Rampopula/mazda_dp_parktronic/mazda_dp_ptronic.pdf

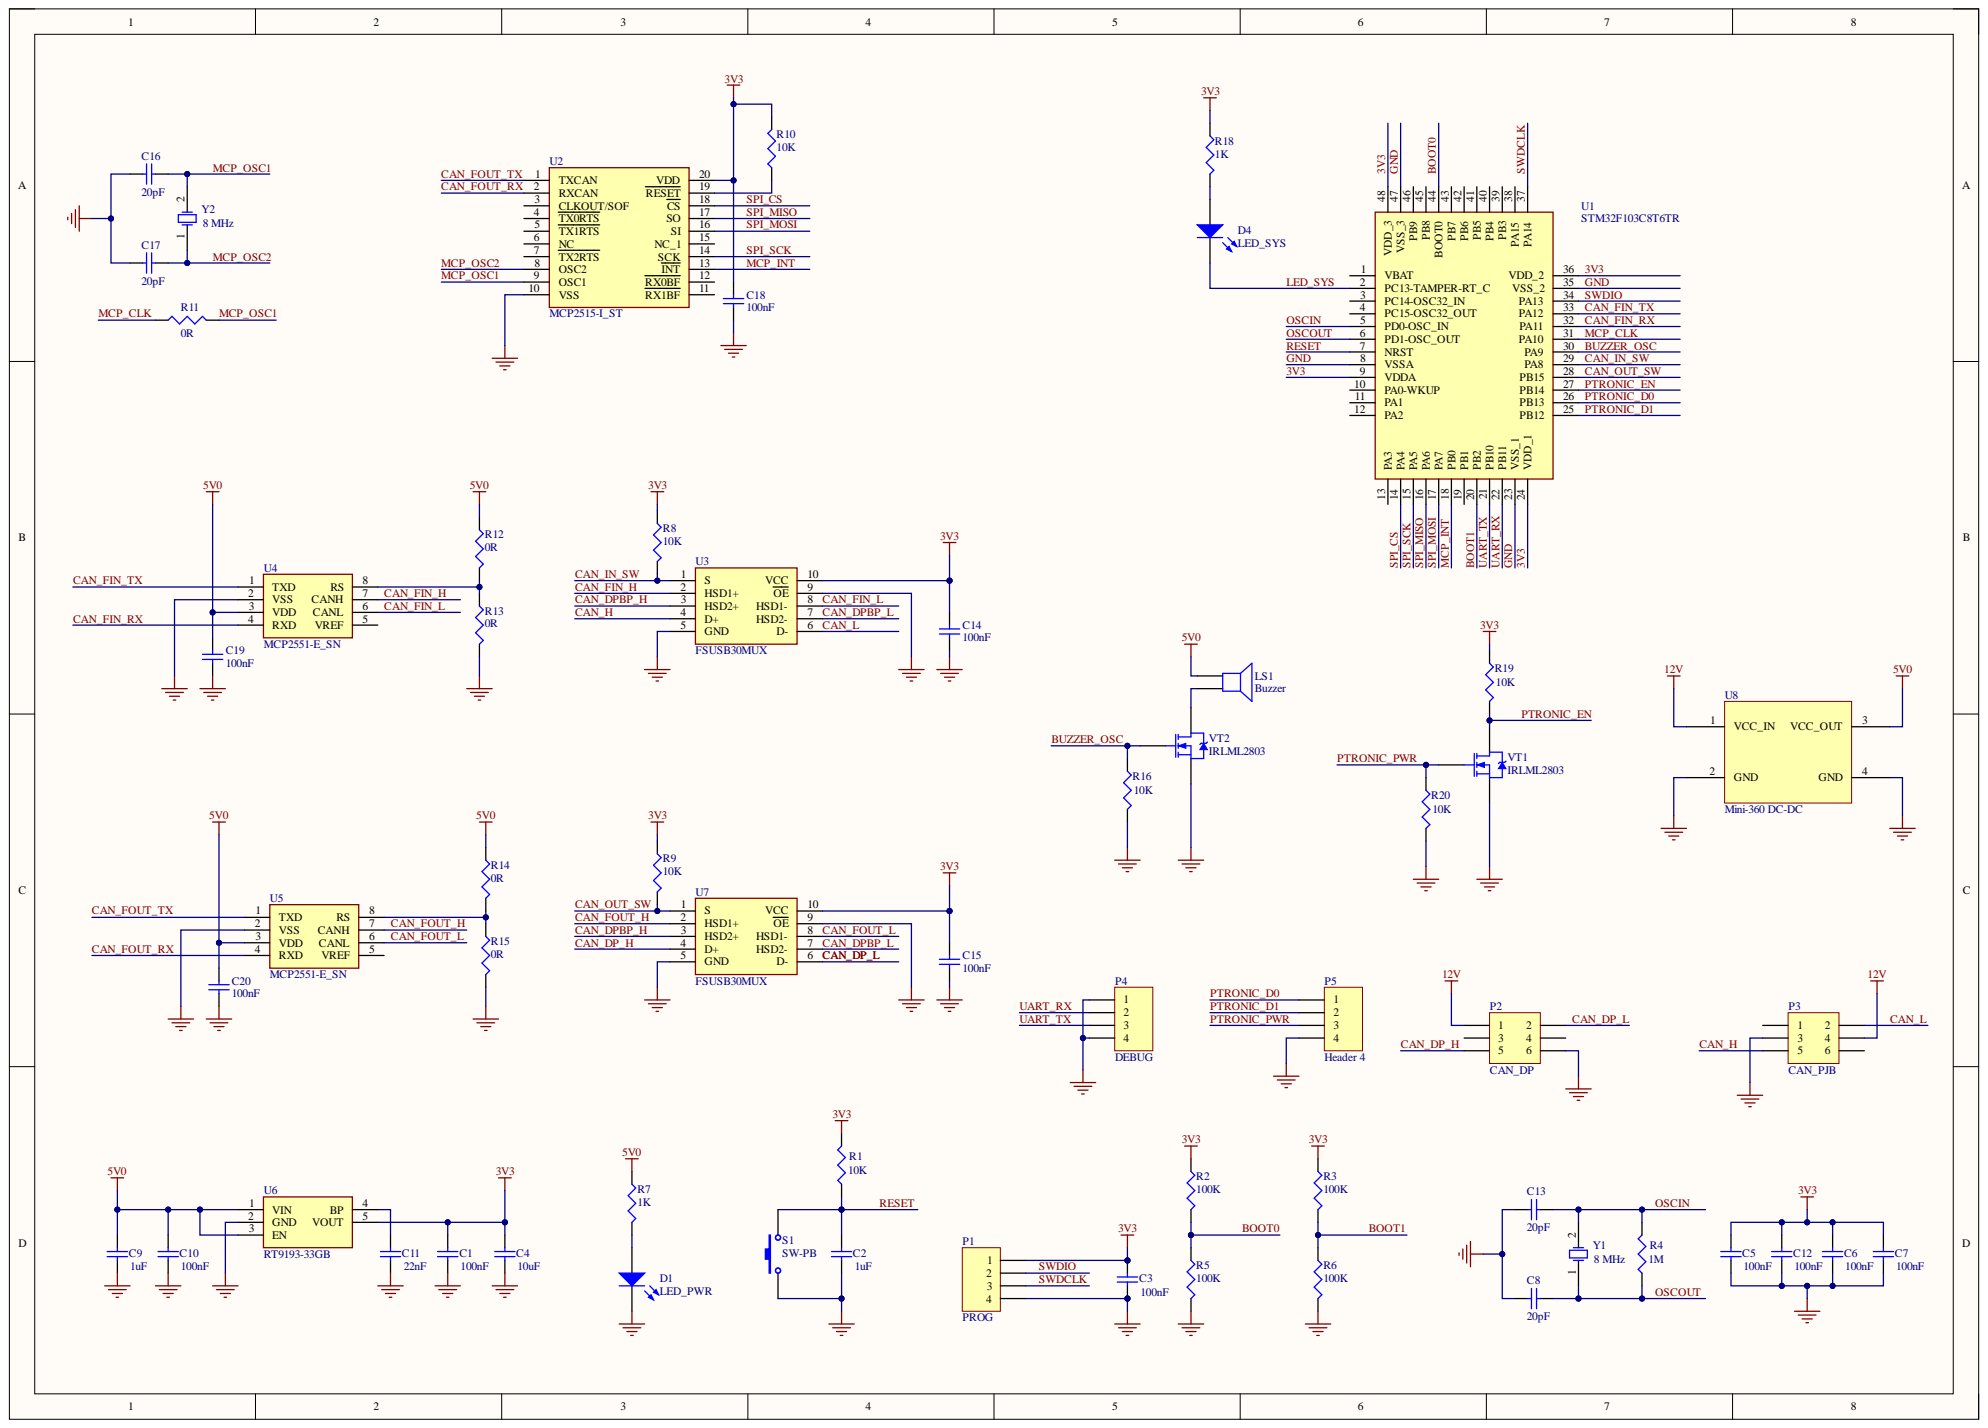
[picture p2: page 1]
