Rampopula/mazda_dp_parktronic/(commit log)

2021-08-16 project: Generate project for stm32f103c8t6 chip
2021-08-16 chip: Enable serial wire debug
2021-08-20 project: Add board information header
2021-08-20 boardinfo: Add app & board ver, name & freq info
2021-08-20 chip: Enable debug UART
2021-08-20 boardinfo: Add debug UART speed definition
2021-08-20 misc: Retarget printf() write to UART
2021-09-06 chip: Enable system LED GPIO
2021-09-20 misc: Add system LED control interface
2021-09-20 boardinfo: Update chip clock defines
2021-09-20 chip: Enable beeper timer
2021-09-24 chip: Enable parktronic input switch GPIO
2021-09-24 misc: Add parktronic input switch interface
2021-09-24 chip: Enable CAN bypass switch GPIO's
2021-09-24 misc: Add CAN bypass switch control interface
2021-09-24 chip: Enable CAN Bus on 125 kbps
2021-09-24 project: Add CAN Bus wrapper stub
2021-09-24 project: Add CAN SPI wrapper stub
2021-09-24 chip: Enable SPI Bus + Chip Select GPIO
2021-09-24 app: Add MCP2515 CAN Controller driver
2021-09-24 app: Implement CAN SPI wrapper
2021-09-24 app: Integrate CAN SPI wrapper
2021-09-24 can_bus: Code refactor
2021-09-24 can_bus: Integrate CAN sniffer module
2021-09-24 app: Add Mazda hand brake definitions
2021-09-24 boardinfo: Update indentation
2021-10-04 boardinfo: Add beeper enabled definition
2022-09-15 [FIX] app: Use log_sys instead of log_info
    [mdp.c]
2022-09-15 app: Optimize algorithm for CAN data replace
    Use bitmasks instead of bit position arrays.
    [mdp.c, mdp.h]
2022-09-15 app: Avoid data copy in parktronic decoder
    [falcon2616.c, falcon2616.h, mdp.c, ptronic_decoder.h]
2022-09-22 app: Use CAN bypass only in error cases
    [boardinfo.h, mdp.c]
2022-09-22 app: Add LED blink for error state
    [mdp.c]
2022-09-23 app: Change parktronic activation method
    Changed parktronic activation method from detection
    parktronic power on GPIO pin into detection reverse gear
    bit in CAN status packet.
    Parktronic power pin now is checked after reverse gear
    bit detection, so if these two conditions are met,
    then parktronic distance data will apear on display.
    Otherwise, the error message will be shown on display.
    [mdp.c]
2022-09-23 project: Attach board circuit diagram
2022-10-25 chip: Add hardware reset pin for MCP2515
2022-10-25 can_bus: Add MCP2515 reset control
    [mcp2515.c, mcp2515_spi_intf.h]
2024-03-21 project: Adjust hardware for board v2
2024-03-21 project: Implement simple CAN Bus test
2024-03-21 app: Swap DP & PJB CAN
    [mdp.c]
2024-03-29 can: Fix SPI CAN RX filter setup
2024-03-29 project: Swap DP & PJB CAN
    [mdp.c]
2024-04-07 project: Add parktronic sensor valid field check
    Version bump
2024-04-26 project: Update error handling for sensors & version bump
    [boardinfo.h, mdp.c]
2024-05-13 project: remove parktronic error prints
    [mdp.c]
2024-05-17 project: Disable parktronic 5v lane check
2024-06-13 project: Change parktronic data pin to PARK1
2024-07-04 project: Update SPI CAN module driver
